Integrated-Project-2-2023-UVic-UCC/balance-board/Pictures/scorpion.png

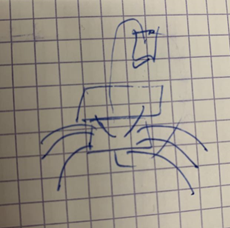
Pictures/scorpion.png
