Integrated-Project-2-2023-UVic-UCC/balance-board/Pictures/Calculation_motor.jpeg

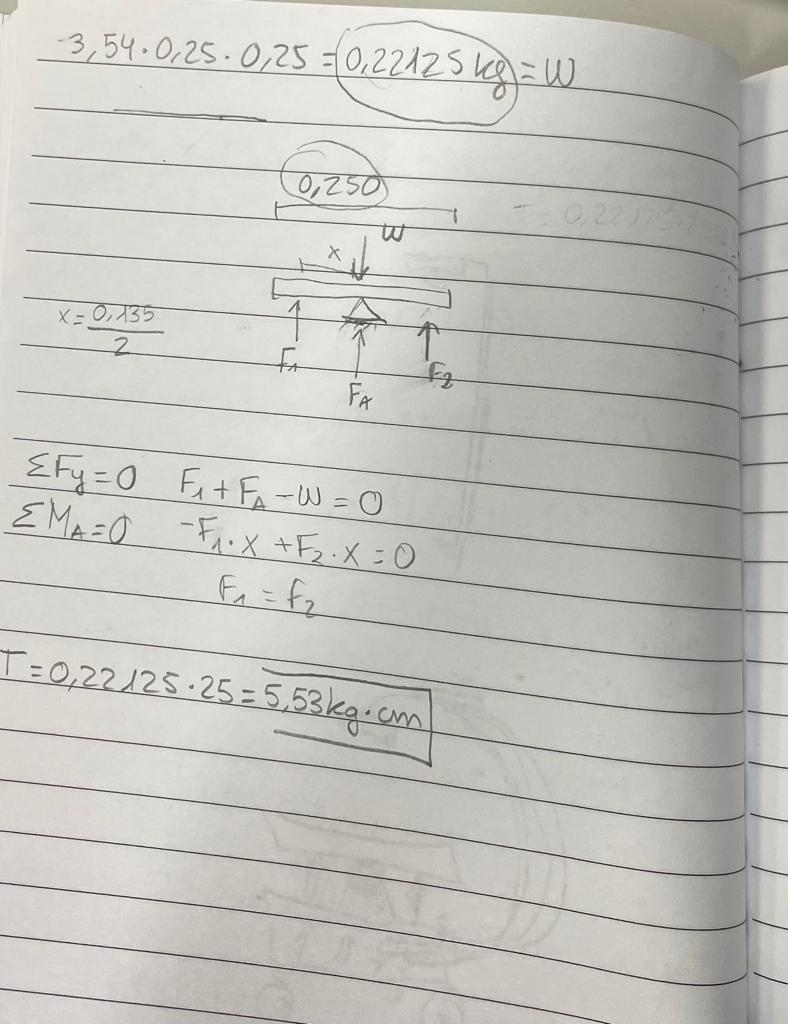
Pictures/Calculation_motor.jpeg
