Integrated-Project-2-2023-UVic-UCC/balance-board/README.md

# Scorpion-balance-board

## Authors
Isaac
David
Hortense
Aïda
