Integrated-Project-2-2023-UVic-UCC/balance-board/Research/SCORPION BALANCE_info.docx

SCORPION BALANCE

This project is made up of two parts, the upper structure (trunk) and the lower structure (trunk).

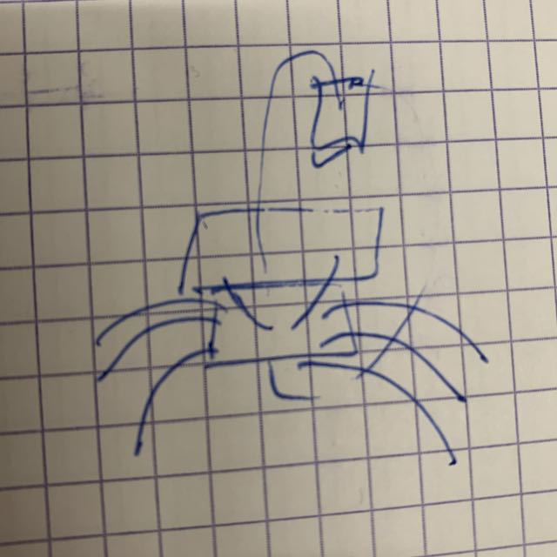
[picture p7: figure]

UPPER STRUCTURE: balance table using PID.

- Computer vision.
- PID.
- Actuation module. (2x servos → DS3218MG 5V-6.8V)

Example:

https://github.com/giusenso/Ball-Balancing-PID-System

LOWER STRUCTURE: leg movement.

- Mechanical engine.
- Actuation module. (1x servo → DS3218MG 5V-6.8V)

Example:

https://www.youtube.com/watch?v=iVVLTqdiBNI

We can do it with an Arduino or with Raspberry pi.
