Integrated-Project-2-2023-UVic-UCC/balance-board/electric_schemes/connection_Hbridge.png

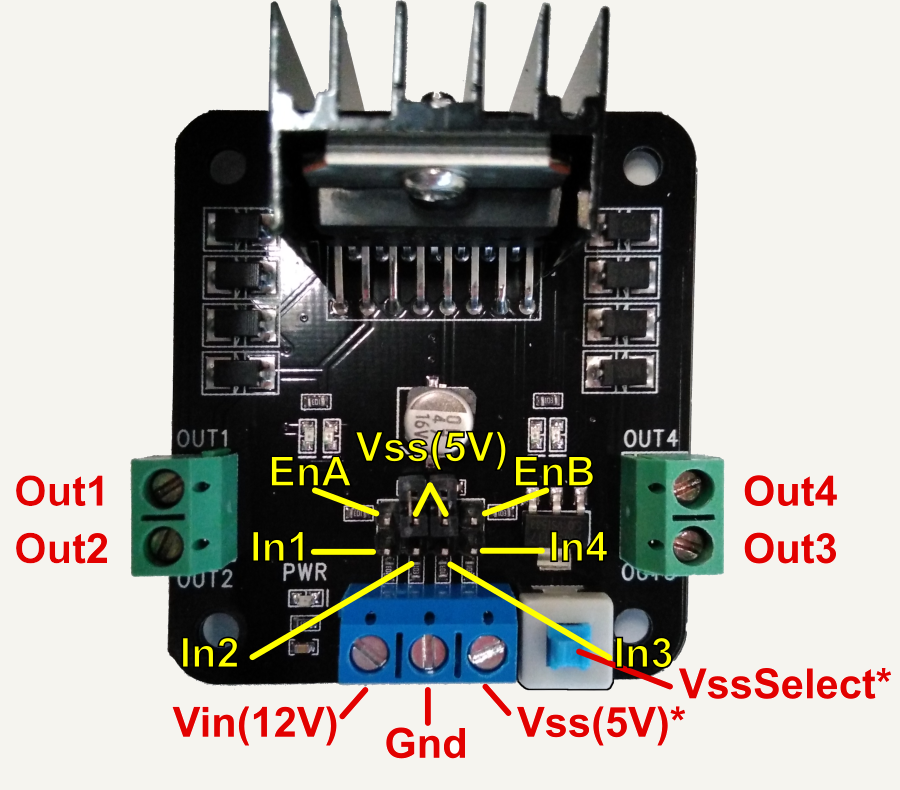
electric_schemes/connection_Hbridge.png
