Integrated-Project-2-2023-UVic-UCC/balance-board/electric_schemes/simple_schemes.png

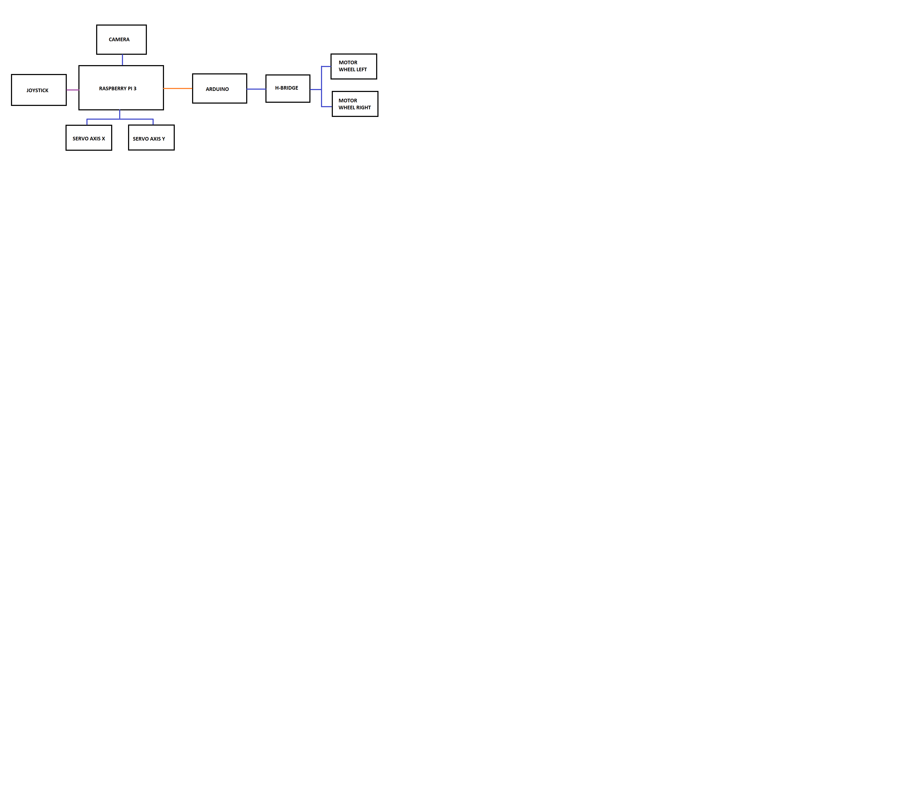
electric_schemes/simple_schemes.png
