Integrated-Project-2-2023-UVic-UCC/balance-board/Other files/Programming_flow.png

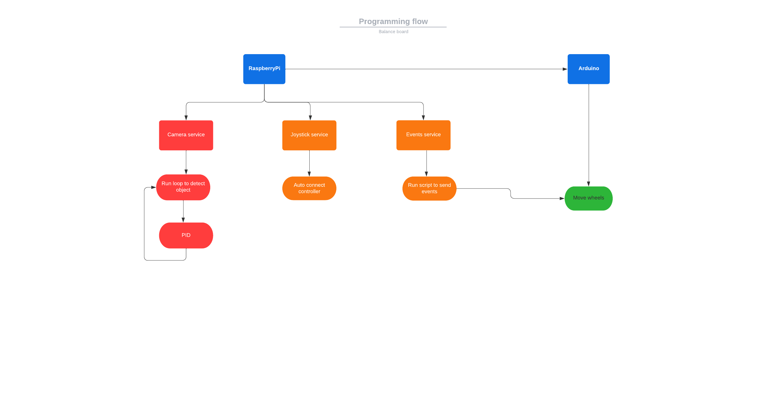
Other files/Programming_flow.png
