Integrated-Project-2-2023-UVic-UCC/balance-board/Pictures/Conceptual_photo.jpeg

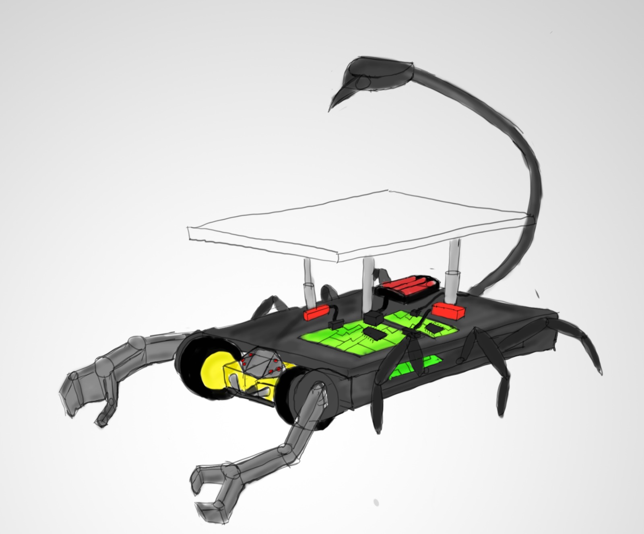
Pictures/Conceptual_photo.jpeg
