Integrated-Project-2-2023-UVic-UCC/balance-board/Shop list/buy_material.xlsx

 | PRICE | QUANTITY | MATERIAL | WEB
 | 59.45 € | 1 | RASPBERRY PI 3 | https://www.raspipc.es/index.php?ver=tienda&accion=verArticulo&idProducto=1751
 | 31.70 € | 1 | RASPBERRY PI 3 CAMERA | https://www.raspipc.es/index.php?ver=tienda&accion=verArticulo&idProducto=1368
 | 6.99 € | 1 | SD CARD for Raspberry PI 3 | https://www.amazon.es/SanDisk-SDSQUA4-032G-GN6MA-microSDHC-Adaptador-Rendimiento/dp/B08GY9NYRM?__mk_es_ES=ÅMÅŽÕÑ
 | 27.54 € | 1 | CARDAN | https://es.rs-online.com/web/p/juntas-universales/5113785
 | 16.88 € | 1 | BASE ROBOT | https://www.amazon.es/AptoFun-Motor-Chassis-Arduino-Battery/dp/B01LW6A2YU?__mk_es_ES=ÅMÅŽÕÑ
 | 4.82 € | 1 | METRAQUILAT: azul, 250x250mm | https://www.muchoplastico.com/es/carrito?action=show
 | 43.18 € | 2 | Servos base | https://www.amazon.es/SUNFOUNDER-TD8120MG-Digital-Aluminium-Control/dp/B07VJG5QTJ?__mk_es_ES=ÅMÅŽÕÑ
 | 21.99 € | 1 | ARDUINO NANO 3 pieces | https://www.amazon.es/AZDelivery-microcontrolador-atmega328-CH340-compatible-V3-CH340/dp/B078SBBST6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ÅMÅŽÕÑ&sp_csd=d2lkZ2V0TmFtZT1zcF9hdGY
 | 10.26 € | 1 | ESLABONES | https://www.amazon.com/ShareGoo-eslabones-dirección-4-331-ajustables/dp/B07VVQ3V5S?ref_=ast_sto_dp
TOTAL | 222.81 €
