Integrated-Project-2-2023-UVic-UCC/balance-board/Other files/IP2_Template_Milestone_1 8 - Revised.xlsx

Sheet: Project Specifications
TECHNICAL SPECIFICATIONS
Customer Company | Universitat de Vic - Universitat Central de Catalunya
Engineering Company | Scorpion balance board
Revision 1 | Date: 28/02/2023
List the main characteristics of the desired device
Item number | Description
1 | Move in any direction with the most narrow movements
2 | Carry load up and down 0,22125 kg
3
4
5
Mechanical part
Dimensions (volume) | 40 cm x 25 cm x 35 cm (height)
Weight | 5 kg
Wheels | 3 wheels 65 mm diameter
Materials for the mechanical part / structure | Metraquilat (250 x 250 x 3 mm), 3D printed parts, commercial wheels
Motors | 2 DC Motors , 170 rpm, Torque = 20.5 kg·cm
Degrees of freedom | 2 for each part
Manufacturing equipment | 3D Printer
Assembly between parts | Bolts and nuts, welding for electrical and electronics parts
Electronic & programming part
Microprocessor | Rasberry pi 3
Drivers | Rasberry pi OS
Sensors | Attached camera
Communication | WiFi Dual Band 2.4 GHz and 5.0 GHz IEEE 802.11b/g/n/ac, Bluetooth 5.0, BLE. Gigabit Ethernet 2 × USB 3.0 ports 2 × USB 2.0 ports
Programming | Python
Power | 5V DC via USB-C connector (3A recommended) 5V DC via GPIO header (3A minimum) Power over Ethernet (PoE)–enabled (requires installation of POE HAT)
Autonomy | Not specified
Protoboard | No
Electronic & programming part
Microcontroller | 3 Arduino Nano
Drivers | None
Sensors | None
Communication | Serial port , Pins
Programming | Arduino IDE
Power | 5V
Autonomy | Depends on the Rasberry pi 3
Protoboard | No

Sheet: Conceptual_Design
CONCEPTUAL DESIGN
Include an image (or more than one) with the current status of the conceptual design. Can be a sketches done with pencil

Sheet: Shopping list
PRELIMINAR ORDER LIST
Team: | Scorpion balance board |  | Total cost [€] | 256.26
 |  |  | Budget limit [€] | 300
Item number | Description of the material | Quantity | Price [€] | Cost [€] | Provider | Link / website
1 | Stepper motor, 200 steps, stall Torque=0,12 Nm, 24 V | 2 | 21.59 | 43.18 | Amazon | https://www.amazon.es/ (https://www.amazon.es/SUNFOUNDER-TD8120MG-Digital-Aluminium-Control/dp/B07VJG5QTJ?__mk_es_ES=ÅMÅŽÕÑ)
2 | Arduino NANO, 5V, Digital I/O Pins: 14, Analog Input Pins: 8 | 1 | 9.99 | 9.99 | Amazon | https://www.amazon.es/ (https://www.amazon.es/AZDelivery-microcontrolador-atmega328-CH340-compatible-V3-CH340/dp/B078SBBST6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ÅMÅŽÕÑ&sp_csd=d2lkZ2V0TmFtZT1zcF9hdGY)
3 | Raspberry Pi 3 | 1 | 59.45 | 59.45 | Raspipc | https://www.raspipc.es/ (https://www.raspipc.es/index.php?ver=tienda&accion=verArticulo&idProducto=1751)
4 | Raspberry Pi 3 camera | 1 | 31.7 | 31.7 | Raspipc | https://www.raspipc.es/ (https://www.raspipc.es/index.php?ver=tienda&accion=verArticulo&idProducto=2014)
5 | SD card for Raspberry Pi 3 | 1 | 6.99 | 6.99 | Amazon | https://www.amazon.es/ (https://www.amazon.es/SanDisk-SDSQUA4-032G-GN6MA-microSDHC-Adaptador-Rendimiento/dp/B08GY9NYRM?__mk_es_ES=ÅMÅŽÕÑ)
6 | Cardan for the table | 1 | 27.54 | 27.54 | RS-Online | https://es.rs-online.com/ (https://es.rs-online.com/web/p/juntas-universales/5113785)
7 | Robot base | 1 | 16.88 | 16.88 | Amazon | https://www.amazon.es/ (https://www.amazon.es/AptoFun-Motor-Chassis-Arduino-Battery/dp/B01LW6A2YU?__mk_es_ES=ÅMÅŽÕÑ)
8 | Eslabones | 1 | 10.26 | 10.26 | Amazon | https://www.amazon.com/ (https://www.amazon.com/ShareGoo-eslabones-dirección-4-331-ajustables/dp/B07VVQ3V5S?ref_=ast_sto_dp)
9 | Extension cable camera Raspberry Pi 3 | 1 | 4.29 | 4.29 | Amazon | https://www.amazon.es/ (https://www.amazon.es/AZDelivery-Repuesto-Raspberry-Cámara-Pantalla/dp/B01N5RS4R2)
10 | PLA print | 1 | 3 | 3
11 | L298N - H bridge | 1 | 3.99 | 3.99 | Amazon | https://www.amazon.es/ (https://www.amazon.es/OcioDual-Controlador-Motores-Driver-Stepper/dp/B07YNR5KWP)
12 | Battery | 1 | 38.99 | 38.99 | Amazon | https://www.amazon.es/ (https://www.amazon.es/Zeee-3600mAh-Batería-Tamiya-Unidades/dp/B0813G4H96)
13 |  |  |  | 0
14 |  |  |  | 0
15 |  |  |  | 0
16 |  |  |  | 0
17 |  |  |  | 0
18 |  |  |  | 0
19 |  |  |  | 0
20 |  |  |  | 0

Sheet: Recommended suppliers
Provider | Description | link
RS Online | distributor of electronics, electricity and industrial maintenance products | https://es.rs-online.com/
BCN 3D Technologies | 3D Printing Filament distributor for our 3D printer BCN 3D Sigma | https://www.bcn3dtechnologies.com/ca/
Robotshop | Stepper motor, grippers, servo motors, arduinos, raspberry Pi, drivers for motors | https://www.robotshop.com/
Motedis | Mechanical components, aluminium profiles | https://www.motedis.es/shop/index.php
Amazon | Electronics and more | https://www.amazon.es/
ALACER MAS | Mechanical components, aluminium profiles | http://www.alacermas.com/index.php
Please check also the list of recommended providers in the virtual campus.
https://campus.uvic.cat/aules/pluginfile.php/830007/mod_resource/content/2/IP2_List_of_possible_providers.pdf
