Integrated-Project-2-2023-UVic-UCC/balance-board/3D design/main plate for the table part 2.SLDPRT

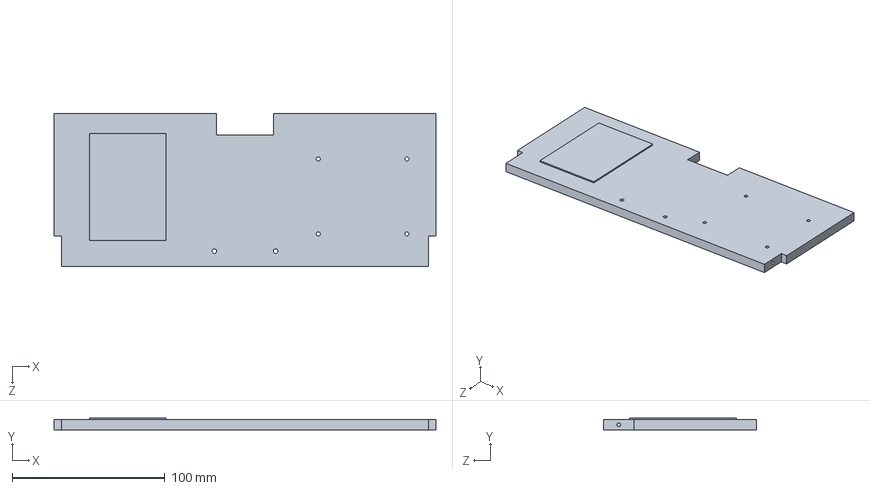
[picture p19: CAD file, 2023-06-05]
3D design/main plate for the table part 2.SLDPRT
250.0 x 8.00 x 100.0 mm
