Integrated-Project-2-2023-UVic-UCC/balance-board/3D design/balance board top final.SLDASM

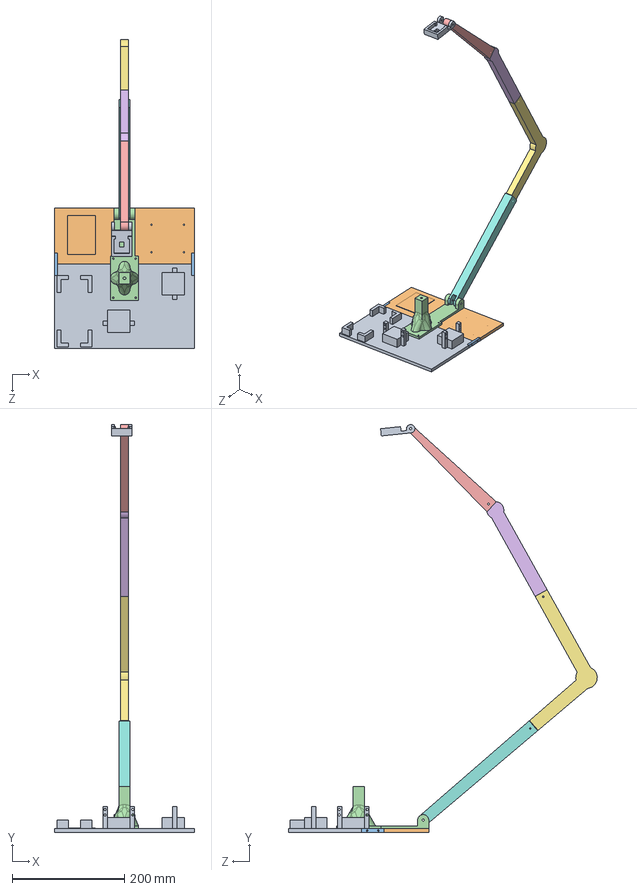
[picture p20: CAD file, 2023-06-05]
3D design/balance board top final.SLDASM
250.0 x 728.1 x 550.6 mm
main plate for the table part 1
main plate for the table part 2
main plate side connector x 2
Teil1
tail top 1
tail top 2
tail lower part 2
tail lower part
camera tail
