Integrated-Project-2-2023-UVic-UCC/balance-board/3D design/balance board wheel final.SLDASM

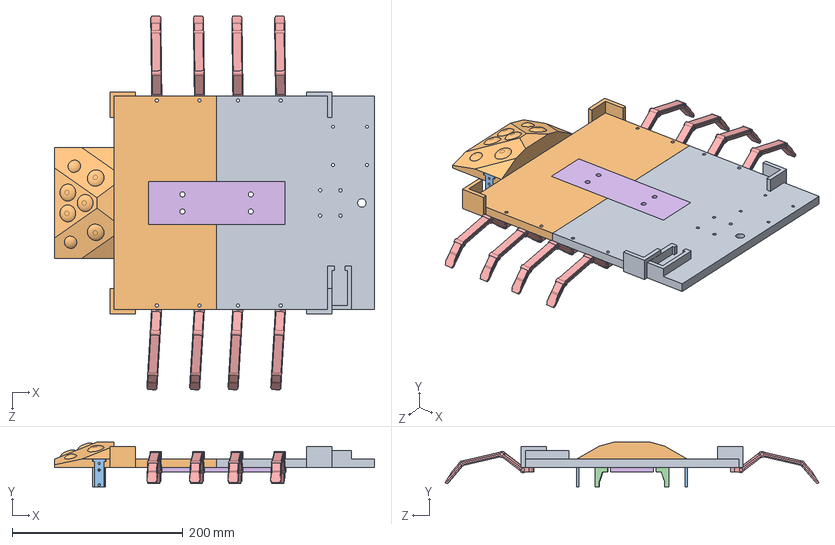
[picture p21: CAD file, 2023-06-05]
3D design/balance board wheel final.SLDASM
375.0 x 52.5 x 437.9 mm
table wheel base plate 3
table wheel base plate 2
outer connector motor x 2
inner connector motor x 2
scorpion leg new x 8
connector skorpion x 2
