Integrated-Project-2-2023-UVic-UCC/balance-board/3D design/main plate for the table part 1.SLDPRT

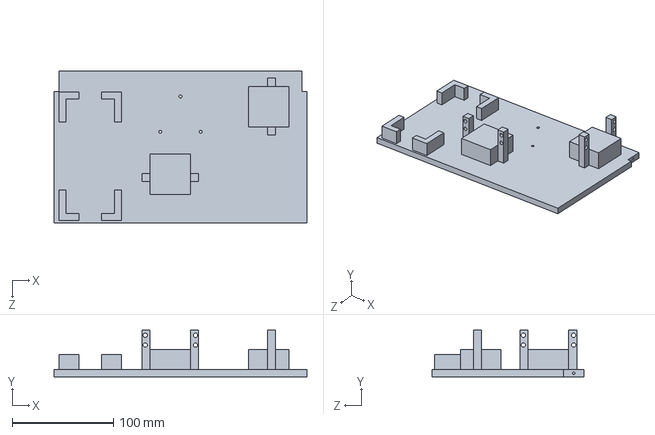
[picture p22: CAD file, 2023-06-05]
3D design/main plate for the table part 1.SLDPRT
250.0 x 46.0 x 150.0 mm
