Integrated-Project-2-2023-UVic-UCC/balance-board/3D design/main plate side connector.SLDPRT

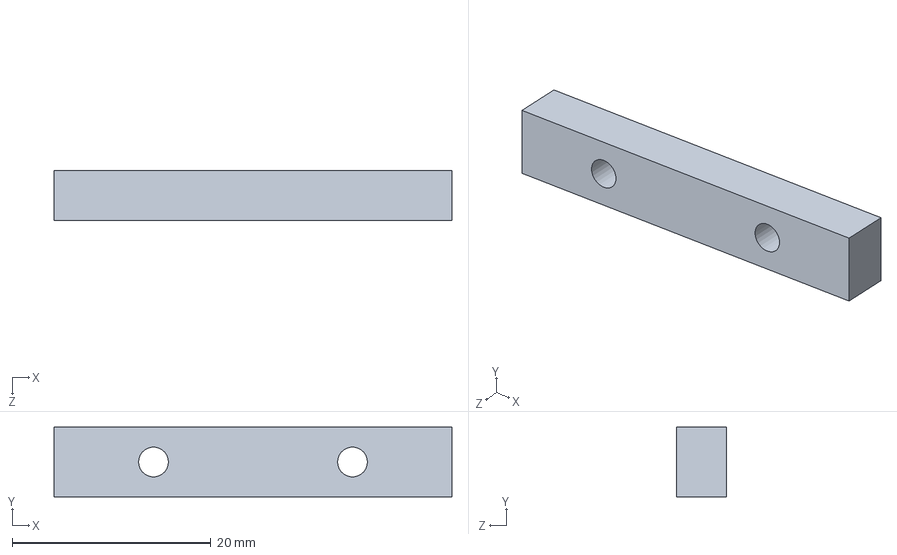
[picture p23: CAD file, 2023-06-05]
3D design/main plate side connector.SLDPRT
40.0 x 7.00 x 5.00 mm
