Integrated-Project-2-2023-UVic-UCC/balance-board/3D design/table wheel base plate 2+3 .SLDPRT.SLDASM

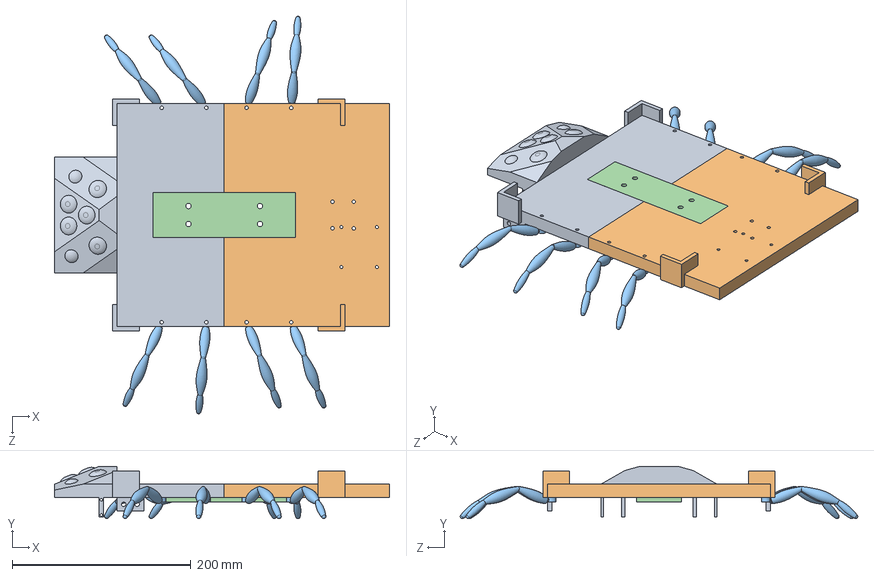
[picture p24: CAD file, 2023-06-05]
3D design/table wheel base plate 2+3 .SLDPRT.SLDASM
375.0 x 58.7 x 445.2 mm
table wheel base plate 2
table wheel base plate 3
leg for scorpion x 8
connector skorpion x 2
