Integrated-Project-2-2023-UVic-UCC/balance-board/3D design/camera tail.SLDPRT

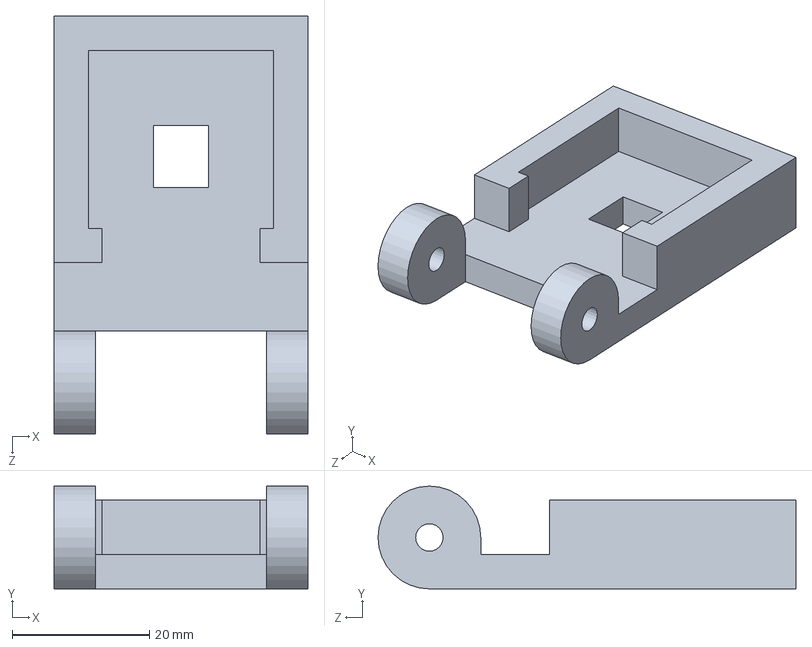
[picture p25: CAD file, 2023-06-05]
3D design/camera tail.SLDPRT
37.0 x 15.0 x 61.0 mm
