Integrated-Project-2-2023-UVic-UCC/balance-board/3D design/table middle leg.SLDPRT

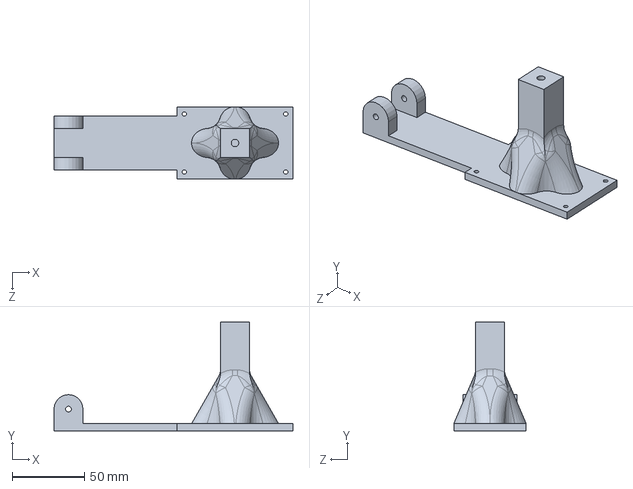
[picture p26: CAD file, 2023-06-05]
3D design/table middle leg.SLDPRT
165.0 x 75.0 x 50.0 mm
