Integrated-Project-2-2023-UVic-UCC/balance-board/3D design/scorpion leg new.SLDPRT

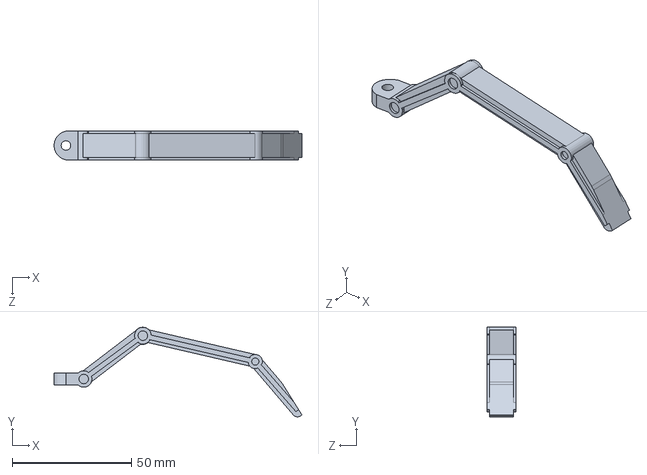
[picture p28: CAD file, 2023-06-05]
3D design/scorpion leg new.SLDPRT
103.8 x 37.5 x 12.0 mm
