Integrated-Project-2-2023-UVic-UCC/balance-board/3D design/table wheel base plate 2.SLDPRT

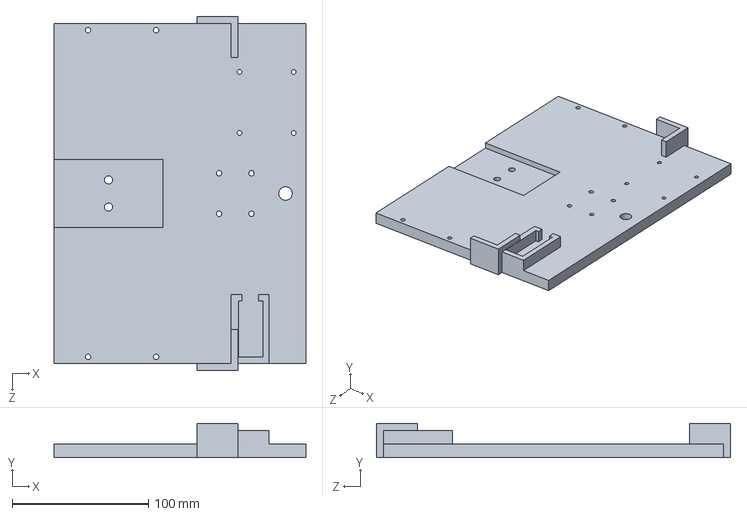
[picture p29: CAD file, 2023-06-05]
3D design/table wheel base plate 2.SLDPRT
185.0 x 25.0 x 260.0 mm
