Integrated-Project-2-2023-UVic-UCC/balance-board/3D design/leg for scorpion.SLDPRT

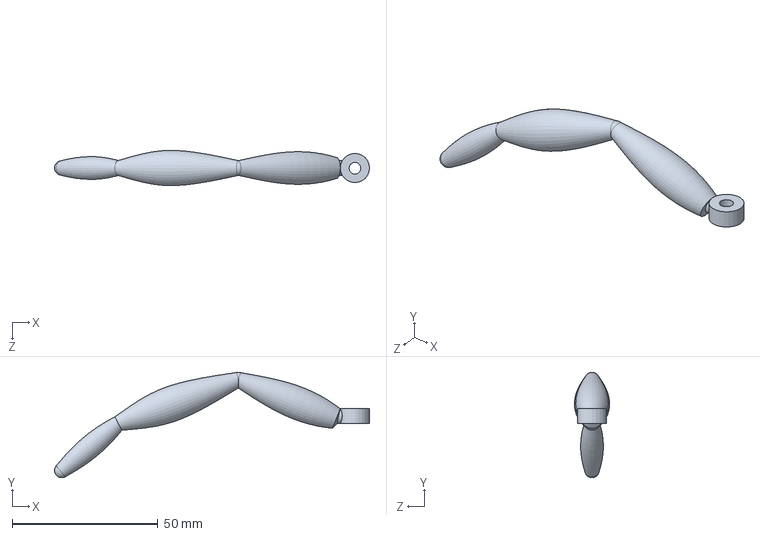
[picture p30: CAD file, 2023-06-05]
3D design/leg for scorpion.SLDPRT
107.9 x 36.1 x 12.1 mm
