Integrated-Project-2-2023-UVic-UCC/balance-board/3D design/connector skorpion.SLDPRT

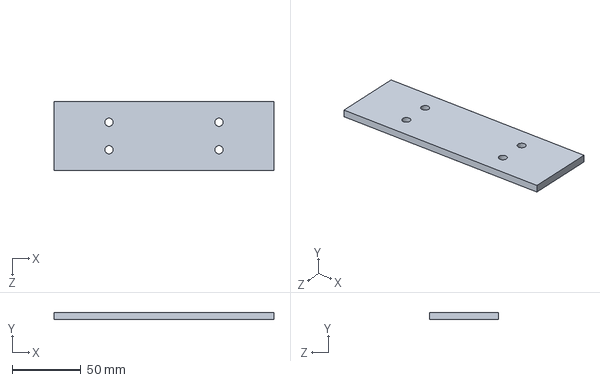
[picture p31: CAD file, 2023-06-05]
3D design/connector skorpion.SLDPRT
160.0 x 5.00 x 50.0 mm
