Integrated-Project-2-2023-UVic-UCC/balance-board/3D design/outer connector motor with toleranz.SLDPRT

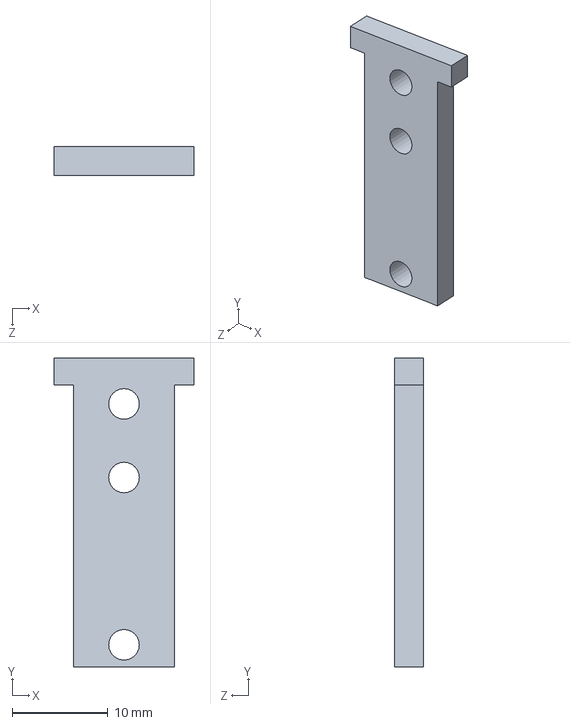
[picture p32: CAD file, 2023-06-05]
3D design/outer connector motor with toleranz.SLDPRT
14.6 x 32.3 x 3.00 mm
