Integrated-Project-2-2023-UVic-UCC/balance-board/3D design/table wheel base plate 1 (1).SLDPRT

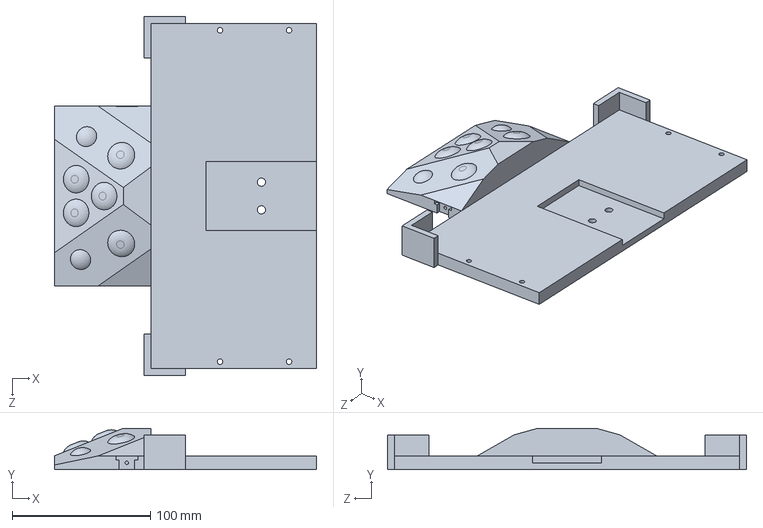
[picture p33: CAD file, 2023-06-05]
3D design/table wheel base plate 1 (1).SLDPRT
190.0 x 30.0 x 260.0 mm
