Integrated-Project-2-2023-UVic-UCC/balance-board/3D design/inner connector motor.SLDPRT

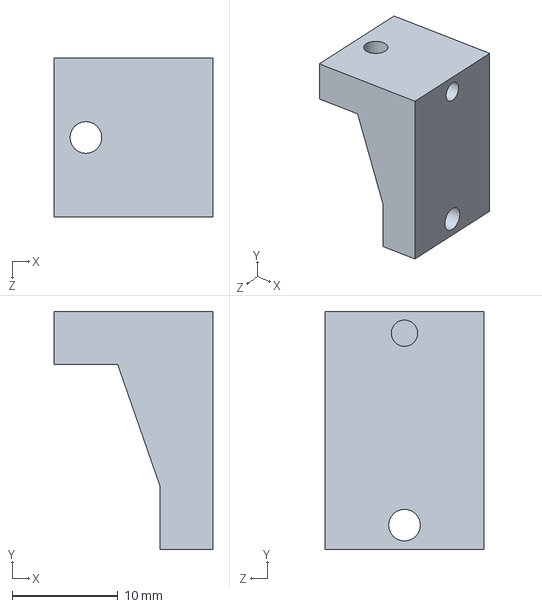
[picture p34: CAD file, 2023-06-05]
3D design/inner connector motor.SLDPRT
15.0 x 22.5 x 15.0 mm
