Integrated-Project-2-2023-UVic-UCC/balance-board/3D design/connector skorpion with toleranz.SLDPRT

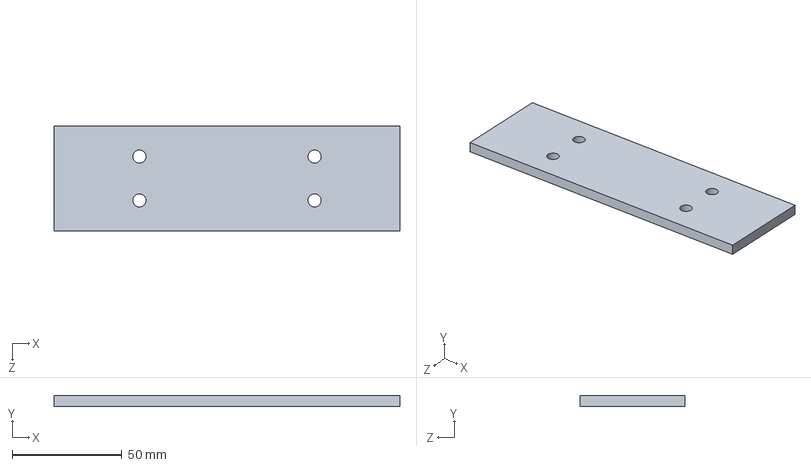
[picture p35: CAD file, 2023-06-05]
3D design/connector skorpion with toleranz.SLDPRT
158.0 x 5.00 x 48.0 mm
