Integrated-Project-2-2023-UVic-UCC/balance-board/(list of files, cad)

Other CAD files:
3D design/camera tail drawing.SLDDRW
3D design/connector skorpion base drawing.SLDDRW
3D design/inner connector motor drawing.SLDDRW
3D design/main plate for the table part 1 drawing.SLDDRW
3D design/main plate for the table part 2 drawing.SLDDRW
3D design/main plate side connector drawing.SLDDRW
3D design/outer connector motor drawing.SLDDRW
3D design/scorpion leg new drawing.SLDDRW
3D design/table middle leg drawing.SLDDRW
3D design/table wheel base plate 1 drawing.SLDDRW
3D design/table wheel base plate 2 drawing.SLDDRW
