Integrated-Project-2-2023-UVic-UCC/balance-board/(threads)

Thread 24 (2023-03-09):

Control dc motors

IsaacAcevedo, 2023-03-09:
- [x] Control velocity of dc motors
- [x] Control two motors at the same time
- [x] Control two motors with different velocity

aidacalero, 2023-03-14:
Done!!!
Name code: "control motors".

Closed 2023-03-14.
