Integrated-Project-2-2023-UVic-UCC/balance-board/electric_schemes/electric_schemes.kicad_pcb

## KiCad design griffin_imate_re.kicad_sch

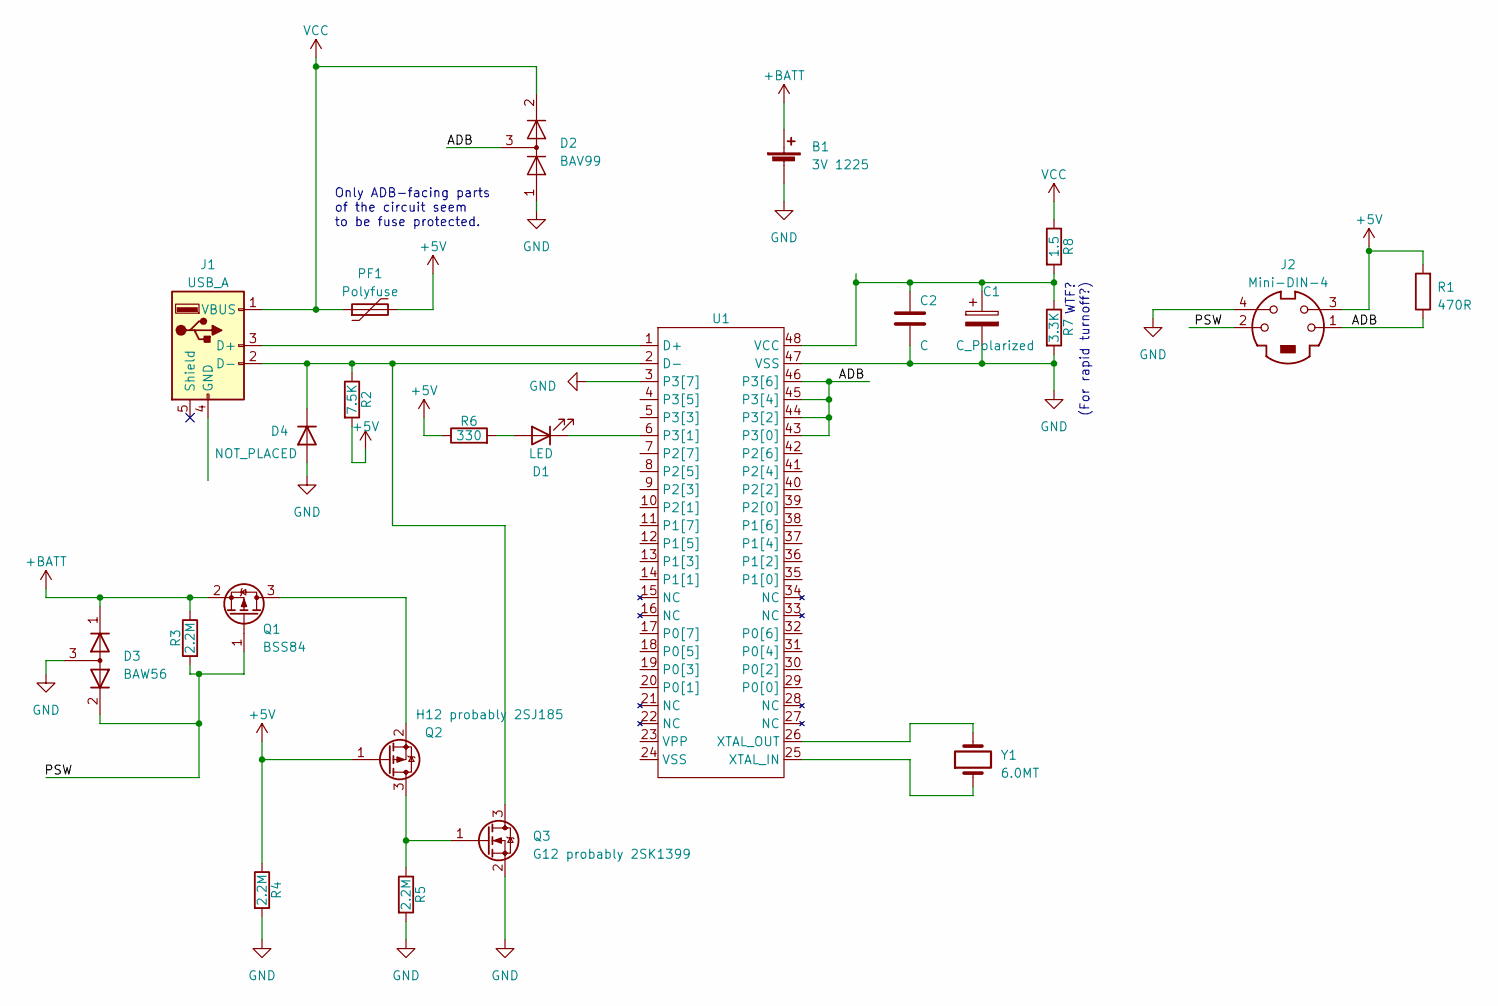
[picture p36: schematic griffin_imate_re.kicad_sch]

Parts:
B1: 3V 1225
C1: C_Polarized
C2: C
D1: LED
D2: BAV99; SOT-23
D3: BAW56
D4: NOT_PLACED
J1: USB_A
J2: Mini-DIN-4
PF1: Polyfuse
Q1: BSS84
Q2: H12 probably 2SJ185
Q3: G12 probably 2SK1399
R1: 470R
R2: 7.5K
R3, R4, R5: 2.2M
R6: 330
R7: 3.3K
R8: 1.5
U1: (no value)
Y1: 6.0MT

Connections:
+5V: J2.3, PF1.2, Q2.1 (G), R1.2, R2.2, R4.1, R6.1
+BATT: B1.1 (+), D3.1 (K), Q1.2 (S), R3.1
ADB: D2.3 (K), J2.1, R1.1, U1.43 (P3[0]), U1.44 (P3[2]), U1.45 (P3[4]), U1.46 (P3[6])
GND: B1.2 (-), C1.2, C2.2, D2.1 (K), D3.3 (A), D4.2 (A), J2.4, Q3.2 (S), R4.2, R5.2, R7.2, U1.3 (P3[7]), U1.47 (VSS)
unnamed: C1.1, C2.1, R7.1, R8.2, U1.48 (VCC)
unnamed: D1.1 (K), U1.6 (P3[1])
unnamed: D1.2 (A), R6.2
unnamed: D4.1 (K), J1.2 (D-), Q3.3 (D), R2.1, U1.2 (D-)
unnamed: J1.3 (D+), U1.1 (D+)
unnamed: Q1.3 (D), Q2.2 (S)
unnamed: Q2.3 (D), Q3.1 (G), R5.1
unnamed: U1.25 (XTAL_IN), Y1.1
unnamed: U1.26 (XTAL_OUT), Y1.2
PSW: D3.2 (K), J2.2, Q1.1 (G), R3.2
VCC: D2.2 (A), J1.1 (VBUS), PF1.1, R8.1

Notes on the sheet:
WTF? (For rapid turnoff?)
Only ADB-facing parts of the circuit seem to be fuse protected.
