Integrated-Project-2-2023-UVic-UCC/balance-board/ImageProcessing/ps4controller.py

import pygame

pygame.init()
j = pygame.joystick.Joystick(0)

j.init()

while True:
    events = pygame.event.get()
    for event in events:
        if event.type == pygame.JOYBUTTONDOWN:
            print("Button pressed ", event.value)
