Integrated-Project-2-2023-UVic-UCC/balance-board/Control_velocity_of_dc_motors/joystickCheck.py

from evdev import InputDevice, categorize, ecodes
from time import sleep
import serial

# Open serial port
ser= serial.Serial('/dev/ttyUSB0',9600)

gamepad = InputDevice('/dev/input/event4')
button_pressed = False

for event in gamepad.read_loop():
    if event.type == ecodes.EV_KEY or event.type == ecodes.EV_ABS:
        if event.value == 1:
            button_pressed = True
            ser.write(str(event.code).encode())
        elif event.value == 0 and button_pressed:
            sleep(1)
            if event.code == 310:
                ser.write(str(10).encode())
            elif event.code == 311:
                ser.write(str(11).encode())

# close port
ser.close() 
