Integrated-Project-2-2023-UVic-UCC/balance-board/(commit log)

2023-02-14 shopping list
    [buy_material.xlsx]
2023-02-21 calulations motors, photo conceptual, Milestone 1 and update shopping list
    [IP2_Template_Milestone_1.xlsx, buy_material.xlsx]
2023-02-23 shopping list update
    [IP2_Template_Milestone_1.xlsx]
2023-02-28 [UPDATE] Updated spreadsheet for Milestone 1
    [IP2_Template_Milestone_1 8 - Revised.xlsx]
2023-03-02 electric schemes
    [electric_schemes.kicad_pcb, electric_schemes.kicad_sch]
2023-03-09 update electric schemes, test from control dc motors arduino
    [electric_schemes.kicad_sch]
2023-03-14 program to control dc motors arduino
2023-03-14 [ADD] Camera check with balltracing
2023-03-14 upgrade schemes electric
    [electric_schemes.kicad_sch, untitled.kicad_sch]
2023-03-16 [ADD]Update camera check with default position
2023-03-16 [FIX]Cleaning up image processing folder
    [cameraCheck.py, pid_control.py]
2023-03-28 individual pieces and their combined model
    [connector skorpion.SLDPRT, leg for scorpion.SLDPRT, table wheel base plate 2+3 .SLDPRT.SLDASM, table wheel base plate 2.SLDPRT, table wheel base plate 3.SLDPRT]
2023-04-11 [ADD]Script that detects joystick
    This operation works on Bluetooth connection which is the desired setting. It will be adapted to movement of the wheels
2023-04-20 [ADD]Test connection arduino and rasberrypi
    The python scripts sends numbers over the serial port to arduino which in turn reads it .
2023-04-25 [Update] Jocktick send to arduino codes
2023-04-27 [ADD] Programming flow without monitor
2023-04-27 [UPDATE] Clean code without prints
2023-06-02 [Update] Updated script for pid control
2023-06-05 top part drawing with skorpion leg and 3d assembly
    [balance board top final.SLDASM, balance board wheel final.SLDASM, camera tail drawing.SLDDRW, main plate for the table part 1 drawing.SLDDRW, main plate for the table part 2 drawing.SLDDRW, main plate side connector drawing.SLDDRW, scorpion leg new drawing.SLDDRW, table middle leg drawing.SLDDRW]
2023-06-05 drawings of the wheel section
    [connector skorpion base drawing.SLDDRW, inner connector motor drawing.SLDDRW, outer connector motor drawing.SLDDRW, table wheel base plate 1 drawing.SLDDRW, table wheel base plate 2 drawing.SLDDRW]
2023-06-05 3d model of the lower plate (wheel pase)
    [connector skorpion with toleranz.SLDPRT, inner connector motor.SLDPRT, outer connector motor with toleranz.SLDPRT, table wheel base plate 1 (1).SLDPRT, table wheel base plate 2.SLDPRT]
2023-06-05 base of the main table 3D models
    [camera tail.SLDPRT, main plate for the table part 1.SLDPRT, main plate for the table part 2.SLDPRT, main plate side connector.SLDPRT, table middle leg.SLDPRT]
2023-06-05 3d model of leg
    [scorpion leg new.SLDPRT]
2023-06-05 [FIX]Cleaning repository
    [IP2_Template_Milestone_1 8 - Revised.xlsx, IP2_Template_Milestone_1.xlsx]
